TableUV/TableUV-Platform/README.md

# Palm-sized Fully Autonomous Table-top Sanitization Robot

 

### Our Reports:
- Final Completion Report: https://github.com/TableUV/TableUV-Platform/blob/master/Final_report.pdf
- Final Design Proposal: https://github.com/TableUV/TableUV-Platform/blob/master/Final_design_proposal.pdf
- Website: https://github.com/TableUV/TableUV.github.io
- Demo Videos: https://www.youtube.com/channel/UCsrsY8ngdr8yEBWj88ymzQw

### Stable Branches:
- https://github.com/TableUV/TableUV/tree/stable/demo-1
- https://github.com/TableUV/TableUV/tree/stable/demo-2-tof-avoidance-20Hz
- https://github.com/TableUV/TableUV/tree/stable/demo-3-encoder-map
---

    

## Poster

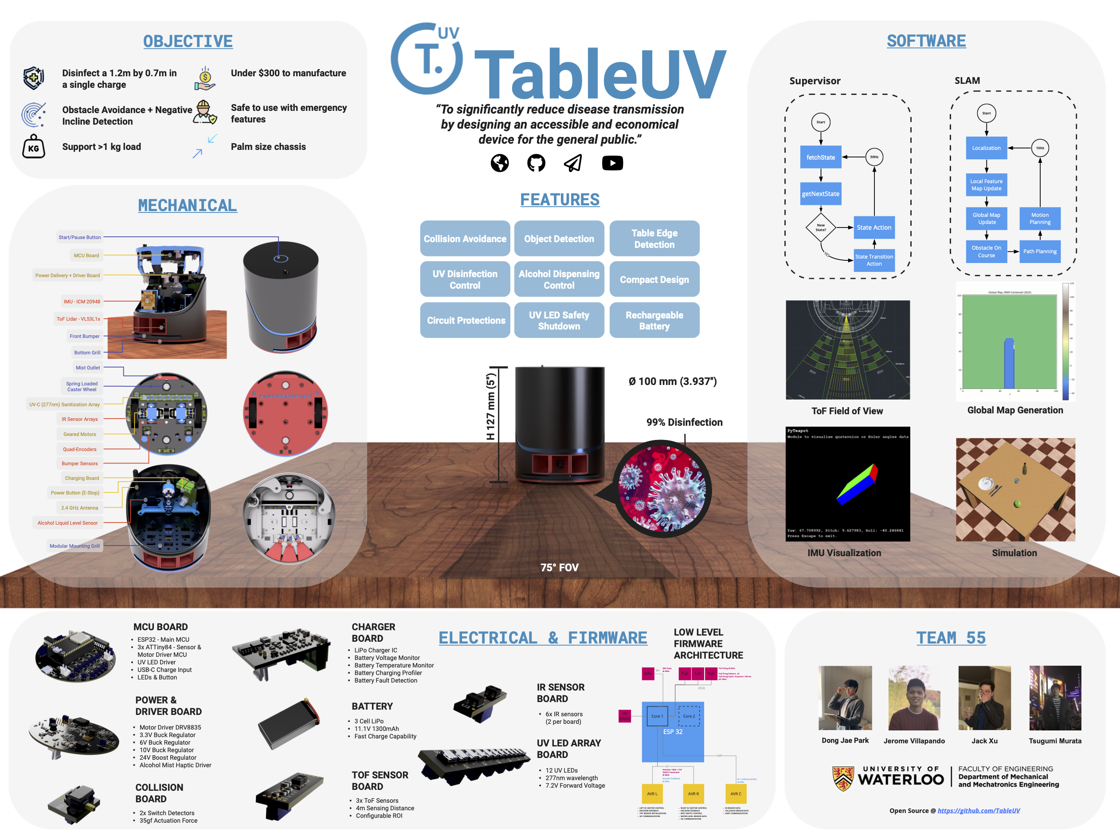
[picture p1: README.assets/Poster_Mar_25.png]
Poster_Mar_25


## Table-UV Robot
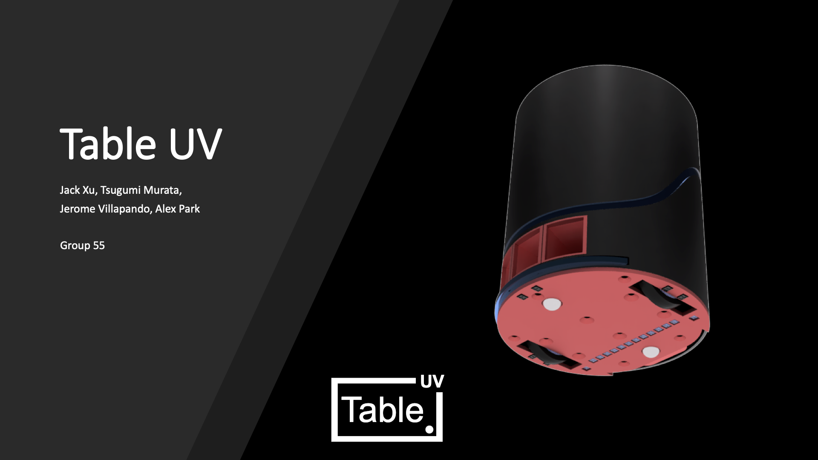
[picture p2: README.assets/FYDP - Presentation-1 (dragged).png]

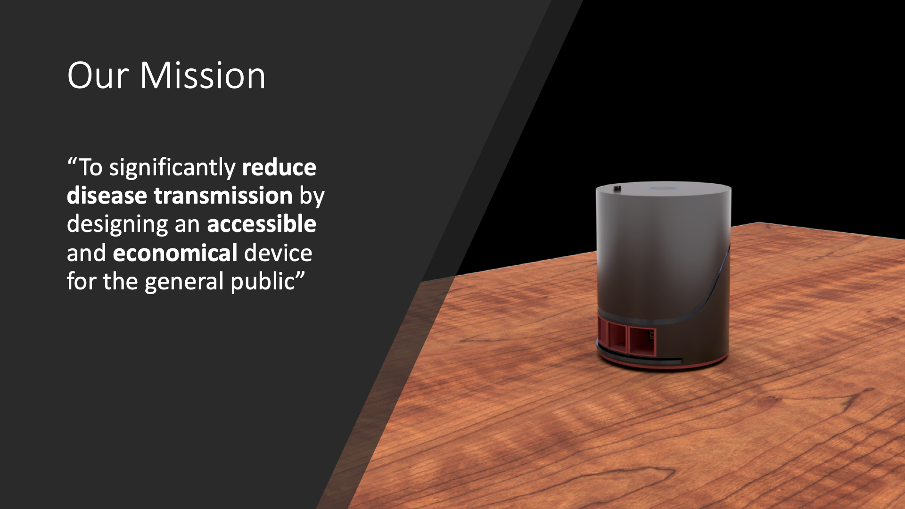
[picture p3: README.assets/FYDP - Presentation-3 (dragged).png]

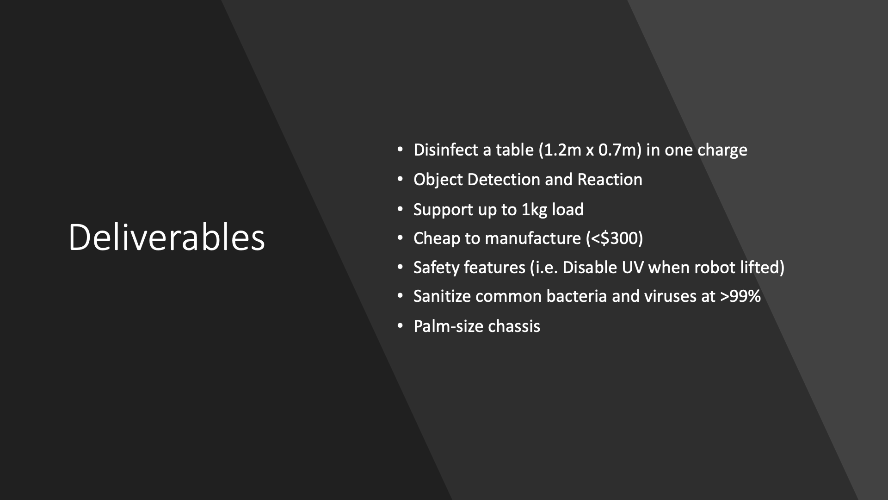
[picture p4: README.assets/FYDP - Presentation-4 (dragged).png]

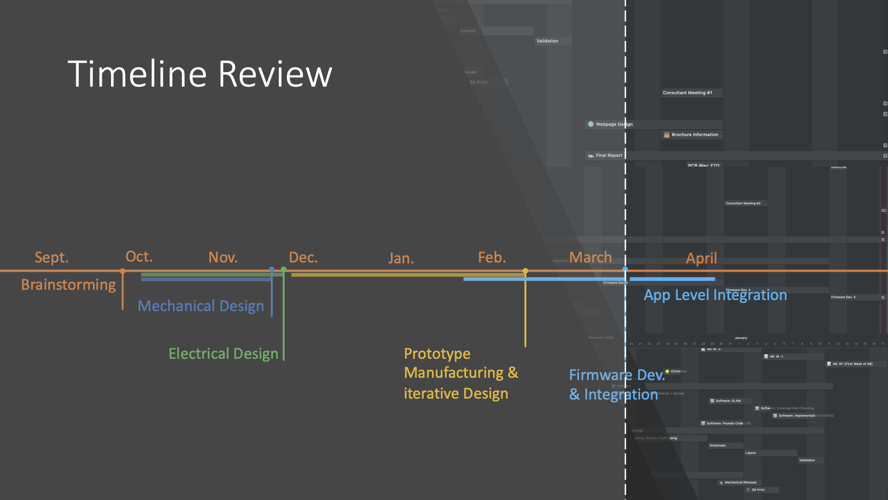
[picture p5: README.assets/FYDP - Presentation-7 (dragged).png]


## Mechanical
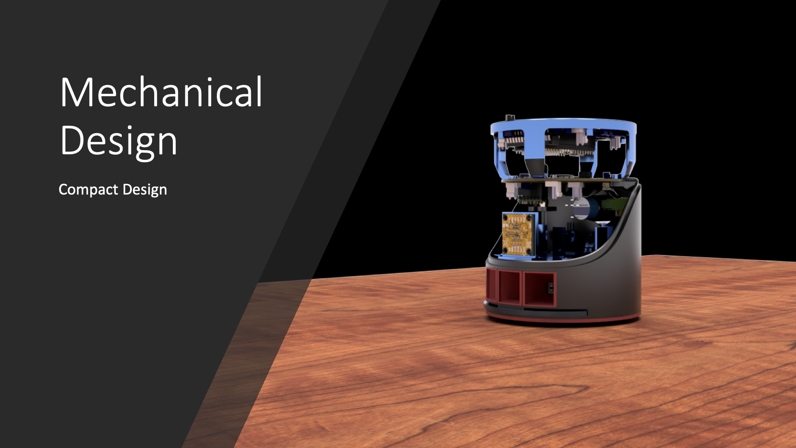
[picture p6: README.assets/FYDP - Presentation-10 (dragged).png]

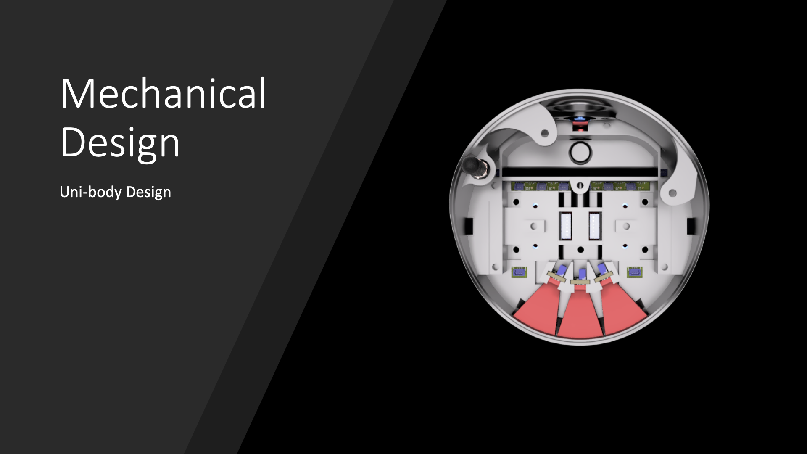
[picture p7: README.assets/FYDP - Presentation-11 (dragged).png]

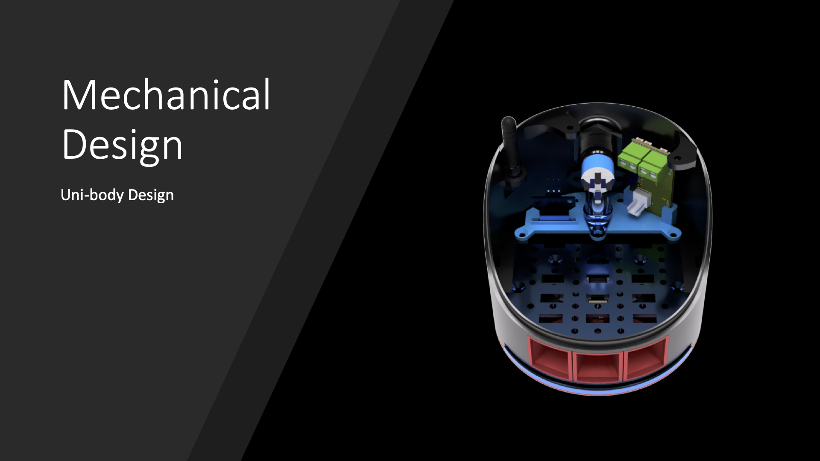
[picture p8: README.assets/FYDP - Presentation-12 (dragged).png]

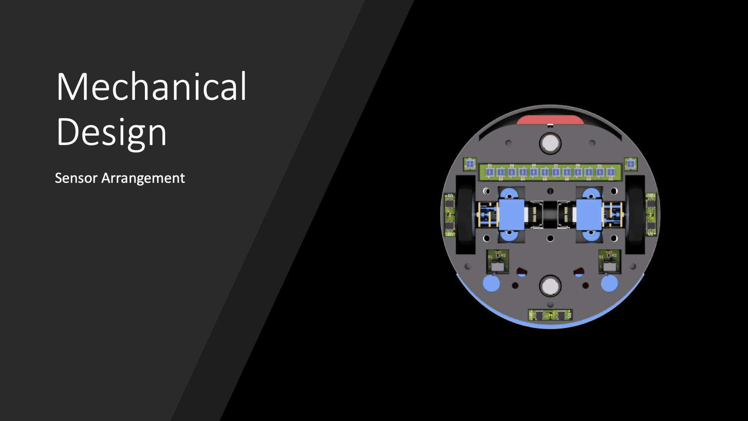
[picture p9: README.assets/FYDP - Presentation-13 (dragged).png]

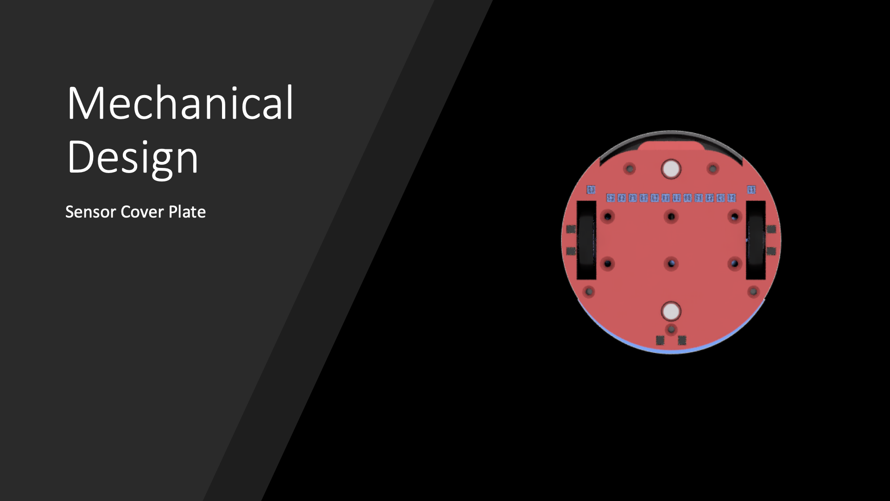
[picture p10: README.assets/FYDP - Presentation-14 (dragged).png]


## Electrical
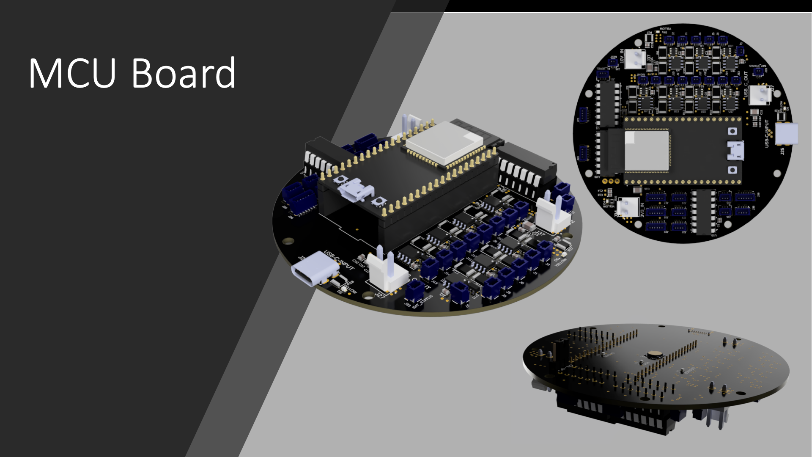
[picture p11: README.assets/FYDP - Presentation-17 (dragged).png]

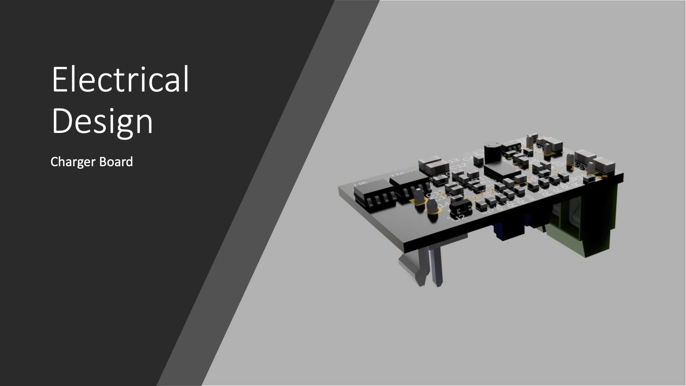
[picture p12: README.assets/FYDP - Presentation2-24 (dragged).png]

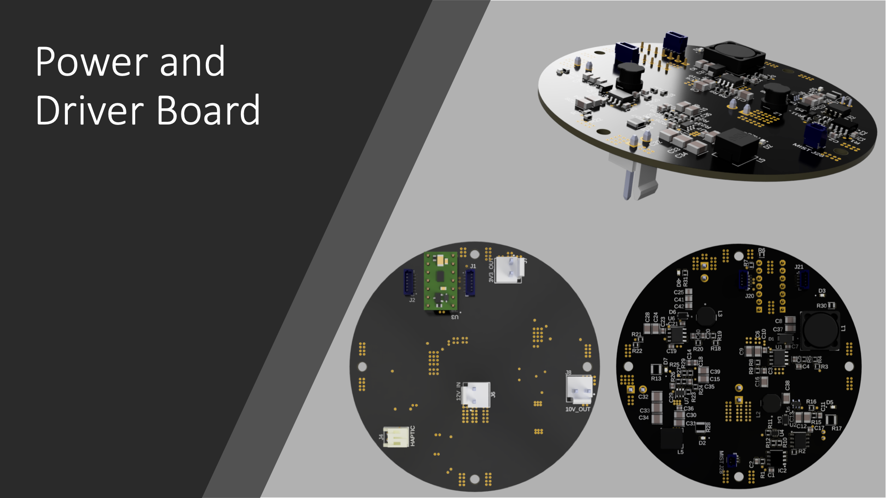
[picture p13: README.assets/FYDP - Presentation2-18 (dragged).png]

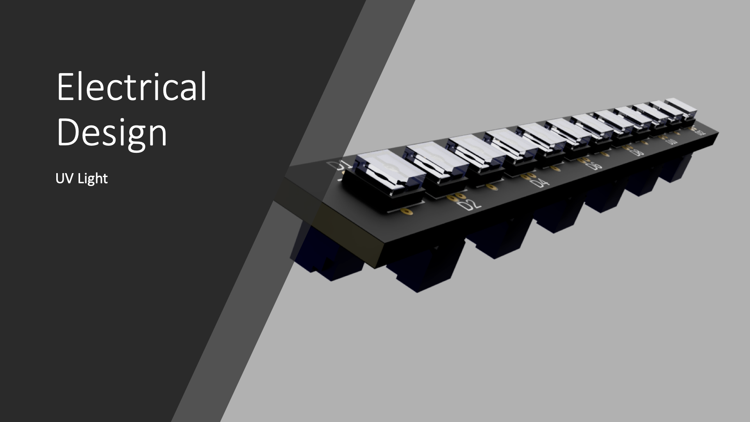
[picture p14: README.assets/FYDP - Presentation2-21 (dragged).png]

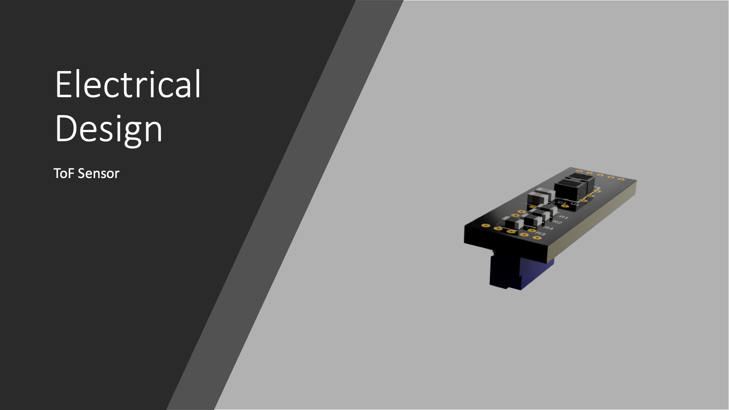
[picture p15: README.assets/FYDP - Presentation2-20 (dragged).png]

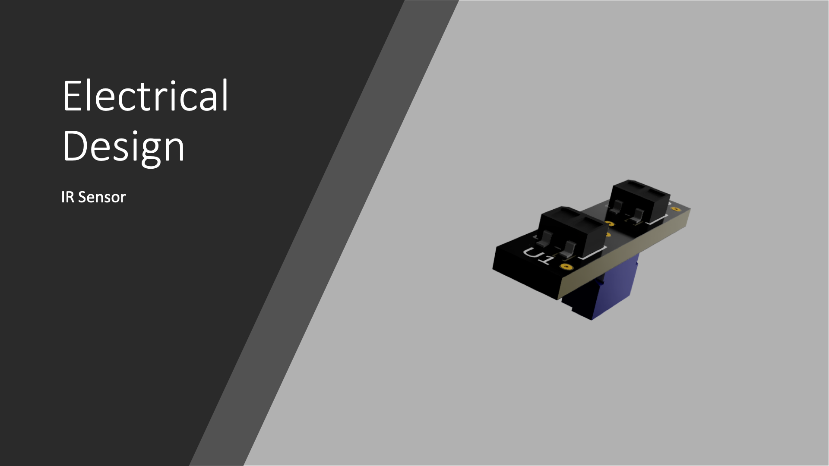
[picture p16: README.assets/FYDP - Presentation2-22 (dragged).png]

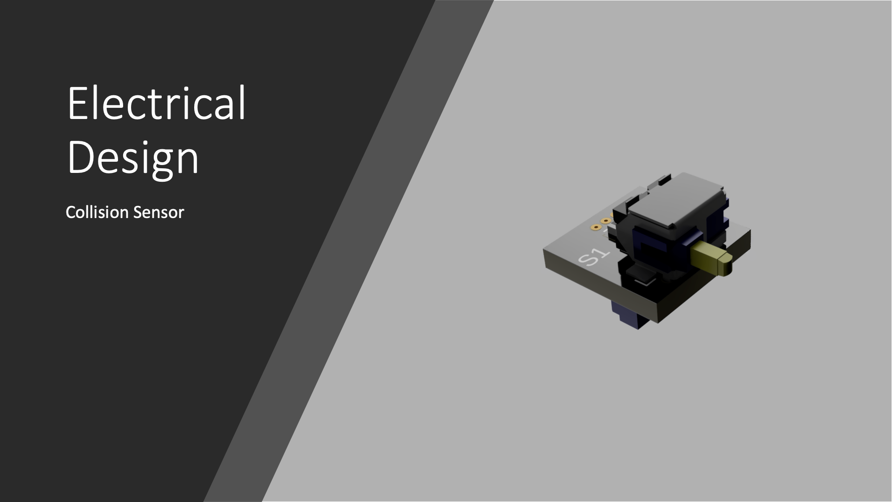
[picture p17: README.assets/FYDP - Presentation2-23 (dragged).png]


## Software
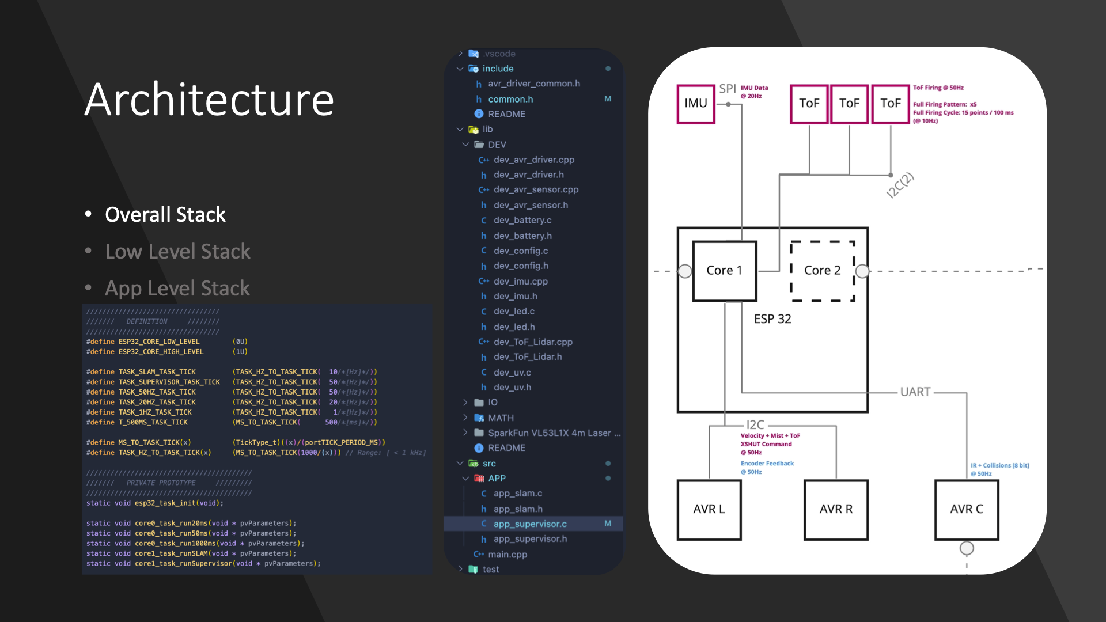
[picture p18: README.assets/FYDP - Presentation2-27 (dragged).png]

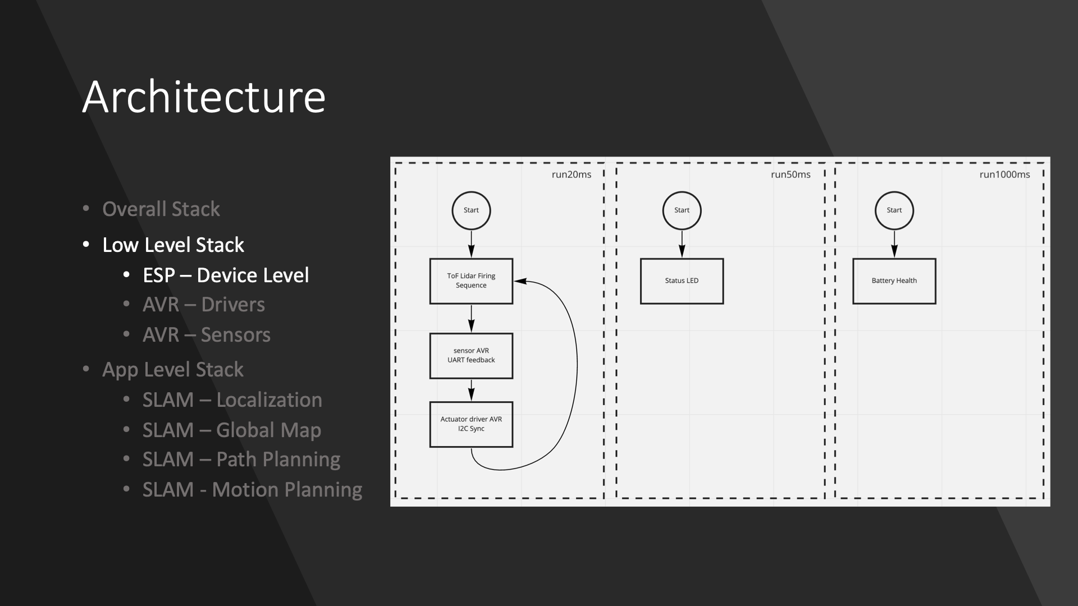
[picture p19: README.assets/FYDP - Presentation2-29 (dragged).png]

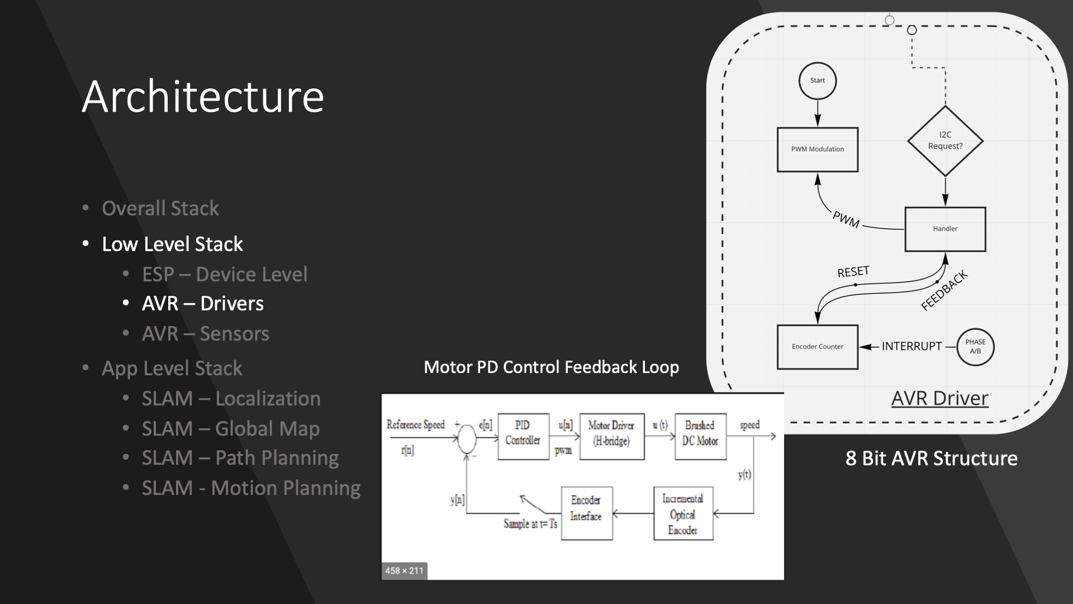
[picture p20: README.assets/FYDP - Presentation2-30 (dragged).png]

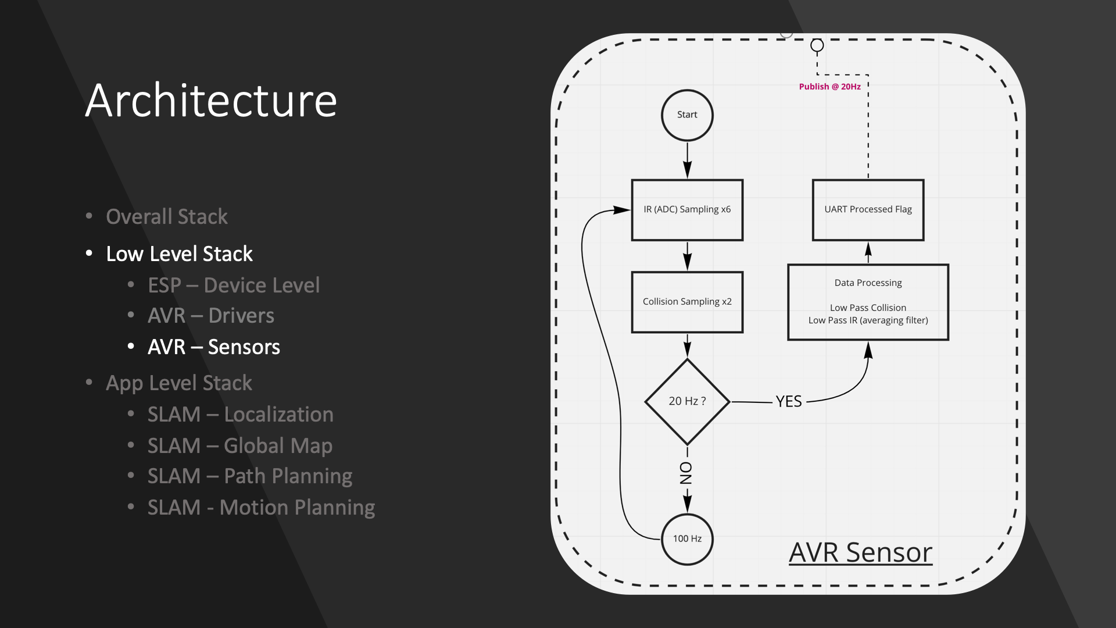
[picture p21: README.assets/FYDP - Presentation2-31 (dragged).png]

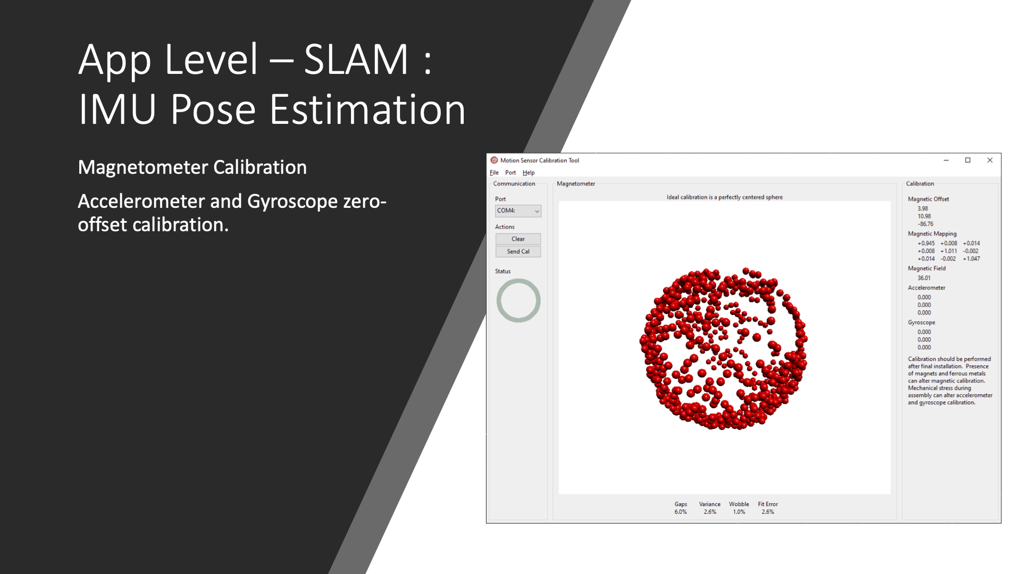
[picture p22: README.assets/FYDP - Presentation2-33 (dragged).png]

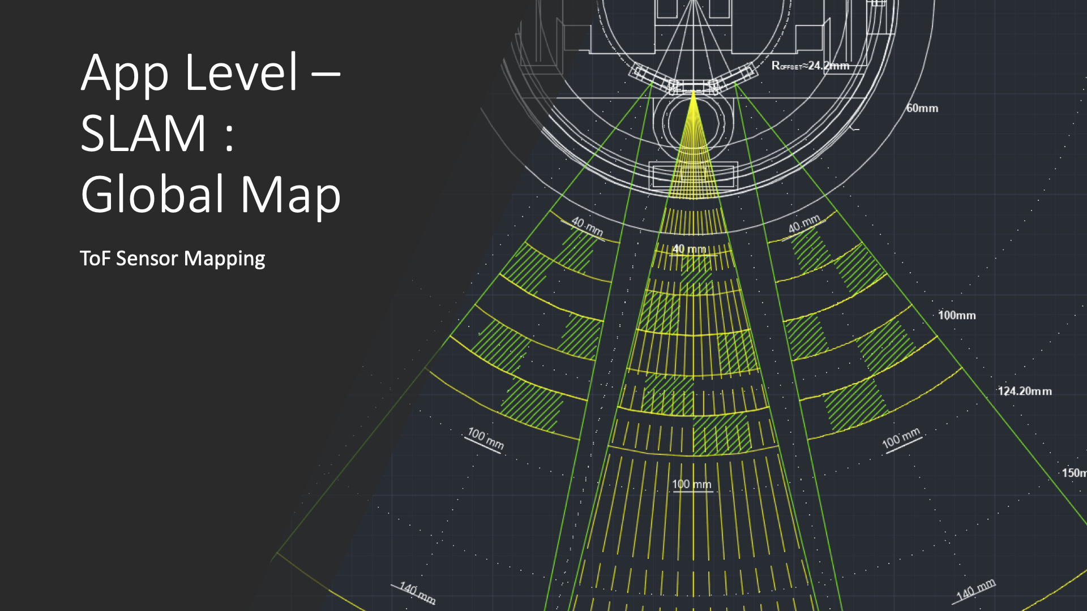
[picture p23: README.assets/FYDP - Presentation2-36 (dragged).png]

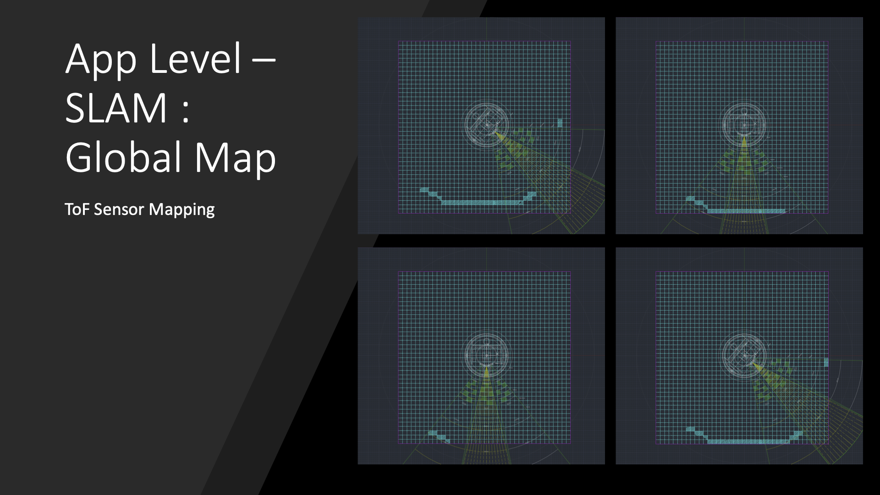
[picture p24: README.assets/FYDP - Presentation2-37 (dragged).png]


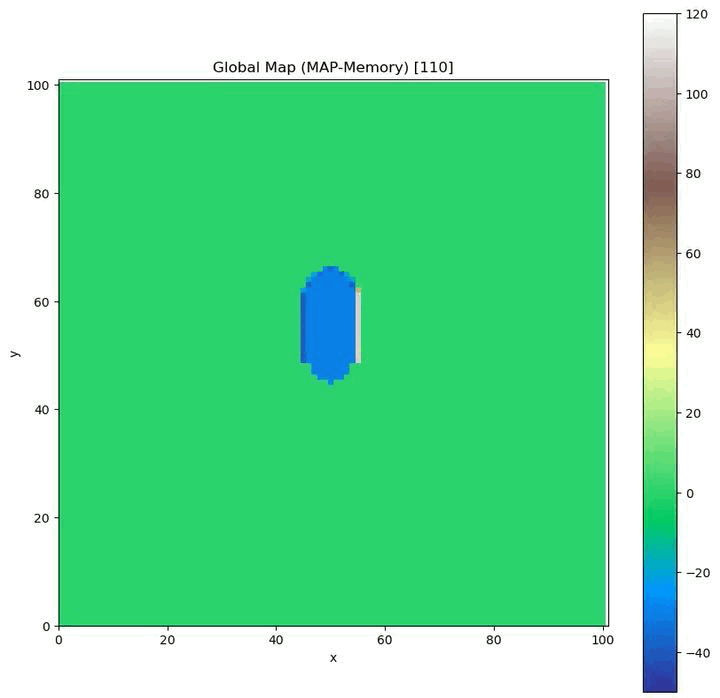
[picture p25: README.assets/OmniPlayerGif_2021_03_11_02_32_53.gif]
OmniPlayerGif_2021_03_11_02_32_53
