TableUV/TableUV-Platform/README.assets/FYDP - Presentation-18 (dragged).png

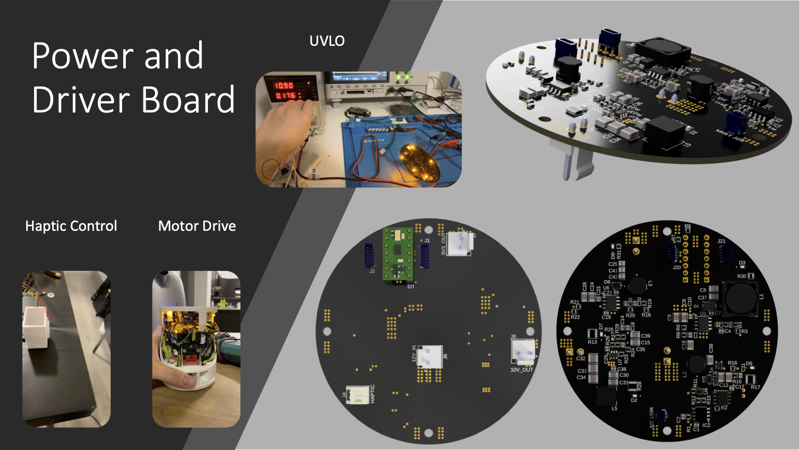
README.assets/FYDP - Presentation-18 (dragged).png
