TableUV/TableUV-Platform/README.assets/OmniPlayerGif_2021_03_11_02_51_19.gif

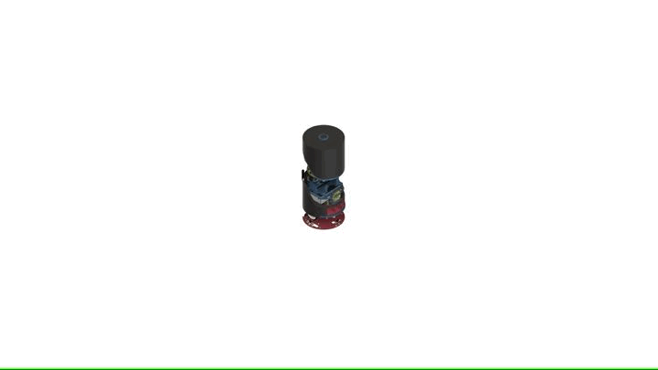
README.assets/OmniPlayerGif_2021_03_11_02_51_19.gif
