TableUV/TableUV-Platform/issues/i2c issue/20hz.png

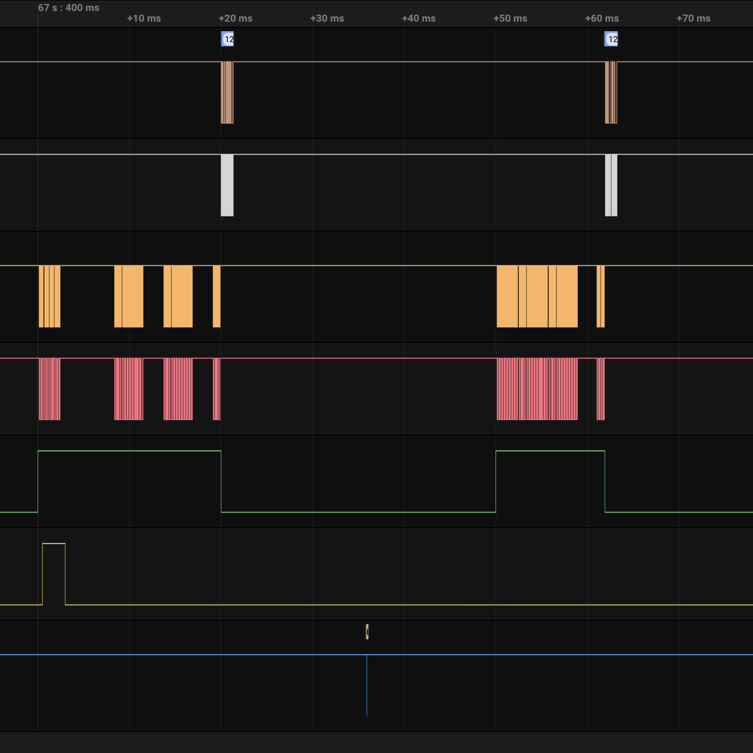
issues/i2c issue/20hz.png
