TableUV/TableUV-Platform/issues/i2c issue/50Hz-Norm.png

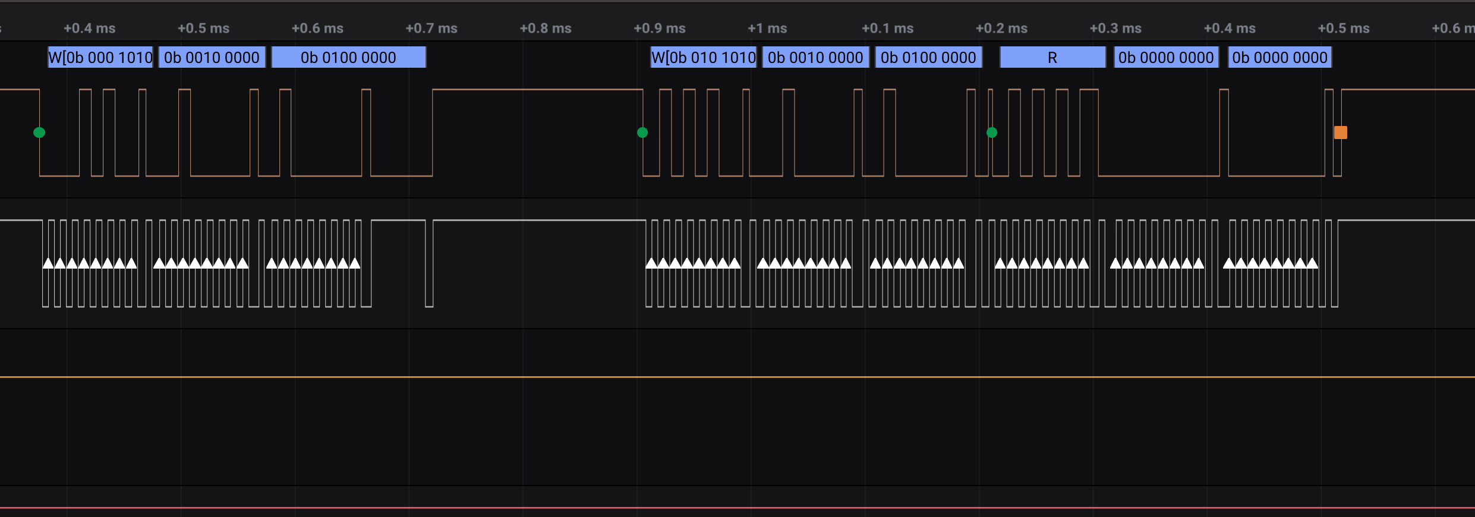
issues/i2c issue/50Hz-Norm.png
