TableUV/TableUV-Platform/issues/i2c issue/50HZ-SCL-low.png

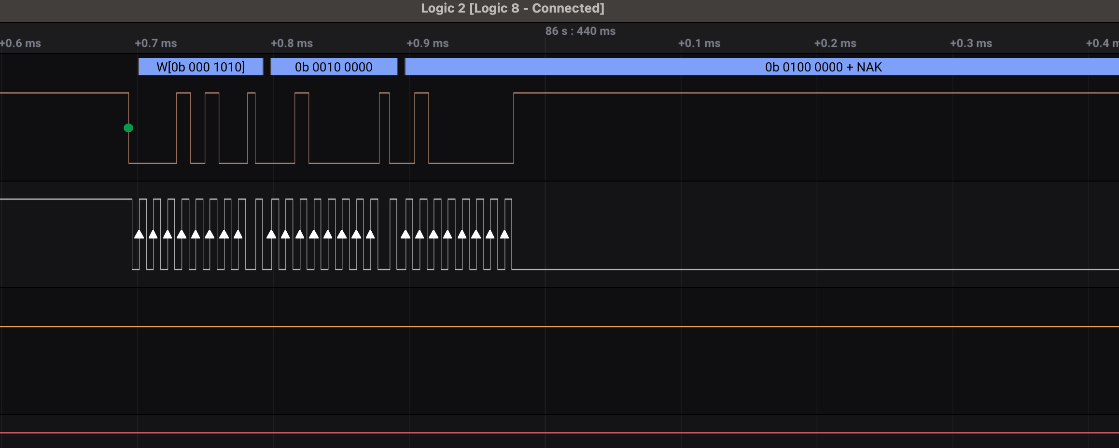
issues/i2c issue/50HZ-SCL-low.png
