TableUV/TableUV-Platform/(commit log)

2021-01-29 add uv driver test code
2021-02-16 [ TableUV Env. Setup ] + device architecture [x]
2021-02-16 + freertos update @ 1hz 10hz 100hz
2021-02-18 Added a pull down to the battery voltage pin
2021-02-18 Implemented functions for battery voltage adc
2021-02-18 Implemented charger status functions
2021-02-18 Only enabled interrupt when needed
2021-02-18 [ TableUV | Arduino Platform ]
2021-02-19 + common.h for feature controls + (wip) ToF Lidar
2021-02-20 brought old esp code to arduino platform
2021-02-20 [ ToF Lidar ] + Complete fire pattern strategy + Auto-update @ 20ms (i2c: 12ms)
    [ Fixes | RTOS ]
    + Update based on frequency instead of task delay
    [common.h, main.cpp]
2021-02-21 Updated the arduino library
2021-02-23 testing new battery code
2021-03-02 add init commit for driver_avr
2021-03-02 add encoder code
2021-03-02 add motor code
2021-03-02 Resolved merge conflicts:
    add slave i2c read and write
    add avr_driver_common.h file and change motor direction notation to CW/CCW
    [avr_driver_common.h, main.c]
2021-03-03 calibrated the voltage monitor
2021-03-06 Fixed some bugs and tested code
    [main.cpp]
2021-03-06 + IMU interface
2021-03-06 + commiting imu before rebase
2021-03-06 + imu implementation
    resolving merge issues
    + comments for functions and removed whitespaces
    updating pin config names for better clarification
2021-03-08 add missing includes
    match encoder count with the rotation direction
    fix data mask error
    set encoder count to 0 after transmit
    fix encoder direction
    [main.c]
2021-03-08 add working test code for right motor
    move forward test code
    add avr_driver_common.h file
    modify avr_driver_common.h to match with one in avr
    add dev_avr_driver_data_S
    add object base code
    add debug code
    add test code
2021-03-08 Started uart RX code
    Wrote test code
    tried testing, uart code, will switch over to esp32softwareserial
    Tested hardwareserial and it worked
    setting up for sensor data
    Changed the uart receive to only receive one byte
    fixed some bugs
    Debugging uart
    Fixed a bug where I was reading from a different stream
    Restructured the functions
    Cleaned up some code
    Added the uart read to the RTOS task
    Implemented tasks properly
    Serial2 was being bottle necked by the new data
    Converted test output to binary
    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
    [app_supervisor.c, app_supervisor.h, common.h, main.c, main.cpp]
2021-03-08 Integrated avr sensor with avr driver
2021-03-08 [ GMap Structure ] + vehicle clearing + dynamic map
    [ ESP ]
    + task init should be last
    [ ToF ]
    + feature flagged debug print for sensor data
2021-03-08 + ir + collision obstacle mapping
    [app_slam.c, slam_serial_visualizer.py]
2021-03-08 + motion planning basic implementation: obstacle avoidance
    [app_slam.c, app_slam.h, app_supervisor.c, common.h]
2021-03-08 bug fix: estop not stopping motor
    [main.c]
2021-03-11 add code for I2C to always send data back to master
2021-03-11 reset i2c command message
    [main.c]
2021-03-11 LED and button functions work
2021-03-11 add timeout on avr driver
2021-03-11 add motor test code
2021-03-11 Changed the adc scaling
2021-03-11 Implemented reading battery and charging status:
    Added a pull down to the battery voltage pin
    Implemented functions for battery voltage adc
    Implemented charger status functions
    Only enabled interrupt when needed
    Small changes
    Resolved pr comments
    Changed update function to not rely on task delay
    Updated the arduino library
    Running test code
    Tested code
    removed test_code
    Renamed enum names
    Changed function to macro
    removed the cli sei
    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
    [main.cpp]
2021-03-11 Fix Dev AVR Driver: Add continuous I2C message trasmit to ESP32
    parent d9084e2a3186e55afcfb27cf80bf9f148f22eeb2
    author Tsugumi Murata <tmurata@uwaterloo.ca> 1615424140 -0500
    committer Tsugumi Murata <tmurata@uwaterloo.ca> 1615491520 -0500
    add code for I2C to always send data back to master
    add message initialize
    add message initialize
    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
    [avr_driver_common.h, main.c]
2021-03-11 implemented button press into supervisor
2021-03-11 Implemented avr_sensor receive functions
    Squashed commit of the following:
    commit 1650b3a7027e0f9cbe36c3cfee127f83f6bd2885
    Merge: 725553b bc8f4a1
    Author: Jerome <jvillapando@ne-rv.com>
    Date: Thu Mar 11 15:37:34 2021 -0500
    Merge branch 'jerome/esp32/sensor_avr_uart_receive' of https://github.com/TableUV/FYDP__TableUV into jerome/esp32/sensor_avr_uart_receive
    commit 725553b874815cf2962c673e844cce30965799ae
    Author: Jerome <jvillapando@ne-rv.com>
    Date: Thu Mar 11 15:30:56 2021 -0500
    Implements code to communicate with Sensor AVR for IR, and collision sensors. This includes:
    Started uart RX code
    tried testing, uart code, will switch over to esp32soft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
    [app_supervisor.c, app_supervisor.h, common.h, main.c, main.cpp]
2021-03-11 + seudocode
    Implementing debouncing
    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
2021-03-11 Implemented leds and avr sensor data to the supervisor
2021-03-11 add mutex lock to i2c code
2021-03-11 Implemented battery voltage into supervisor
2021-03-12 Fixed a bug where i wasn't going to the fault state
    Forgot to register the gpio isr
    Made some bugfxies
    Added todos
    [app_supervisor.c, main.cpp]
2021-03-12 add timeout and delete encod and waterlevel request
    delete encoder and waterlevel en
    add mutex lock
    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
2021-03-12 Fixed LED bug
2021-03-12 + workspace for arduino and avr
2021-03-20 + avr sensor mapping integration & tested
2021-03-27 + uv enabled + fix supervisor nodes
    [app_supervisor.c, common.h]
2021-03-27 Imported dev avr sensor
2021-03-28 + incorporate with new avr driver (merge later from tsugumi))
2021-03-28 Fixed a conversion bug
    [avr_driver_common.h]
2021-03-28 Only storing encoder values in dev_avr_driver not velocity
2021-03-28 Implemented encoder buffer to pose in slam_math
2021-03-28 Implemented encoder into app_slam
2021-03-28 + fixes and averaging mode
    [app_slam.c, app_supervisor.c, common.h, main.cpp]
2021-03-29 + working version + i2c issues reported here
    [app_slam.c, common.h, main.cpp, slam_serial_visualizer.py]
2021-03-29 + issues i2c
2021-03-29 + state action - bug fix
    [app_supervisor.c]
